AlexEkb4ever/MURMULATOR_RP3B_case_scheme/19RPI24/19RPI24.kicad_pcb

## KiCad design 19RPI24/19RPI24.kicad_pcb (2024-05-10)

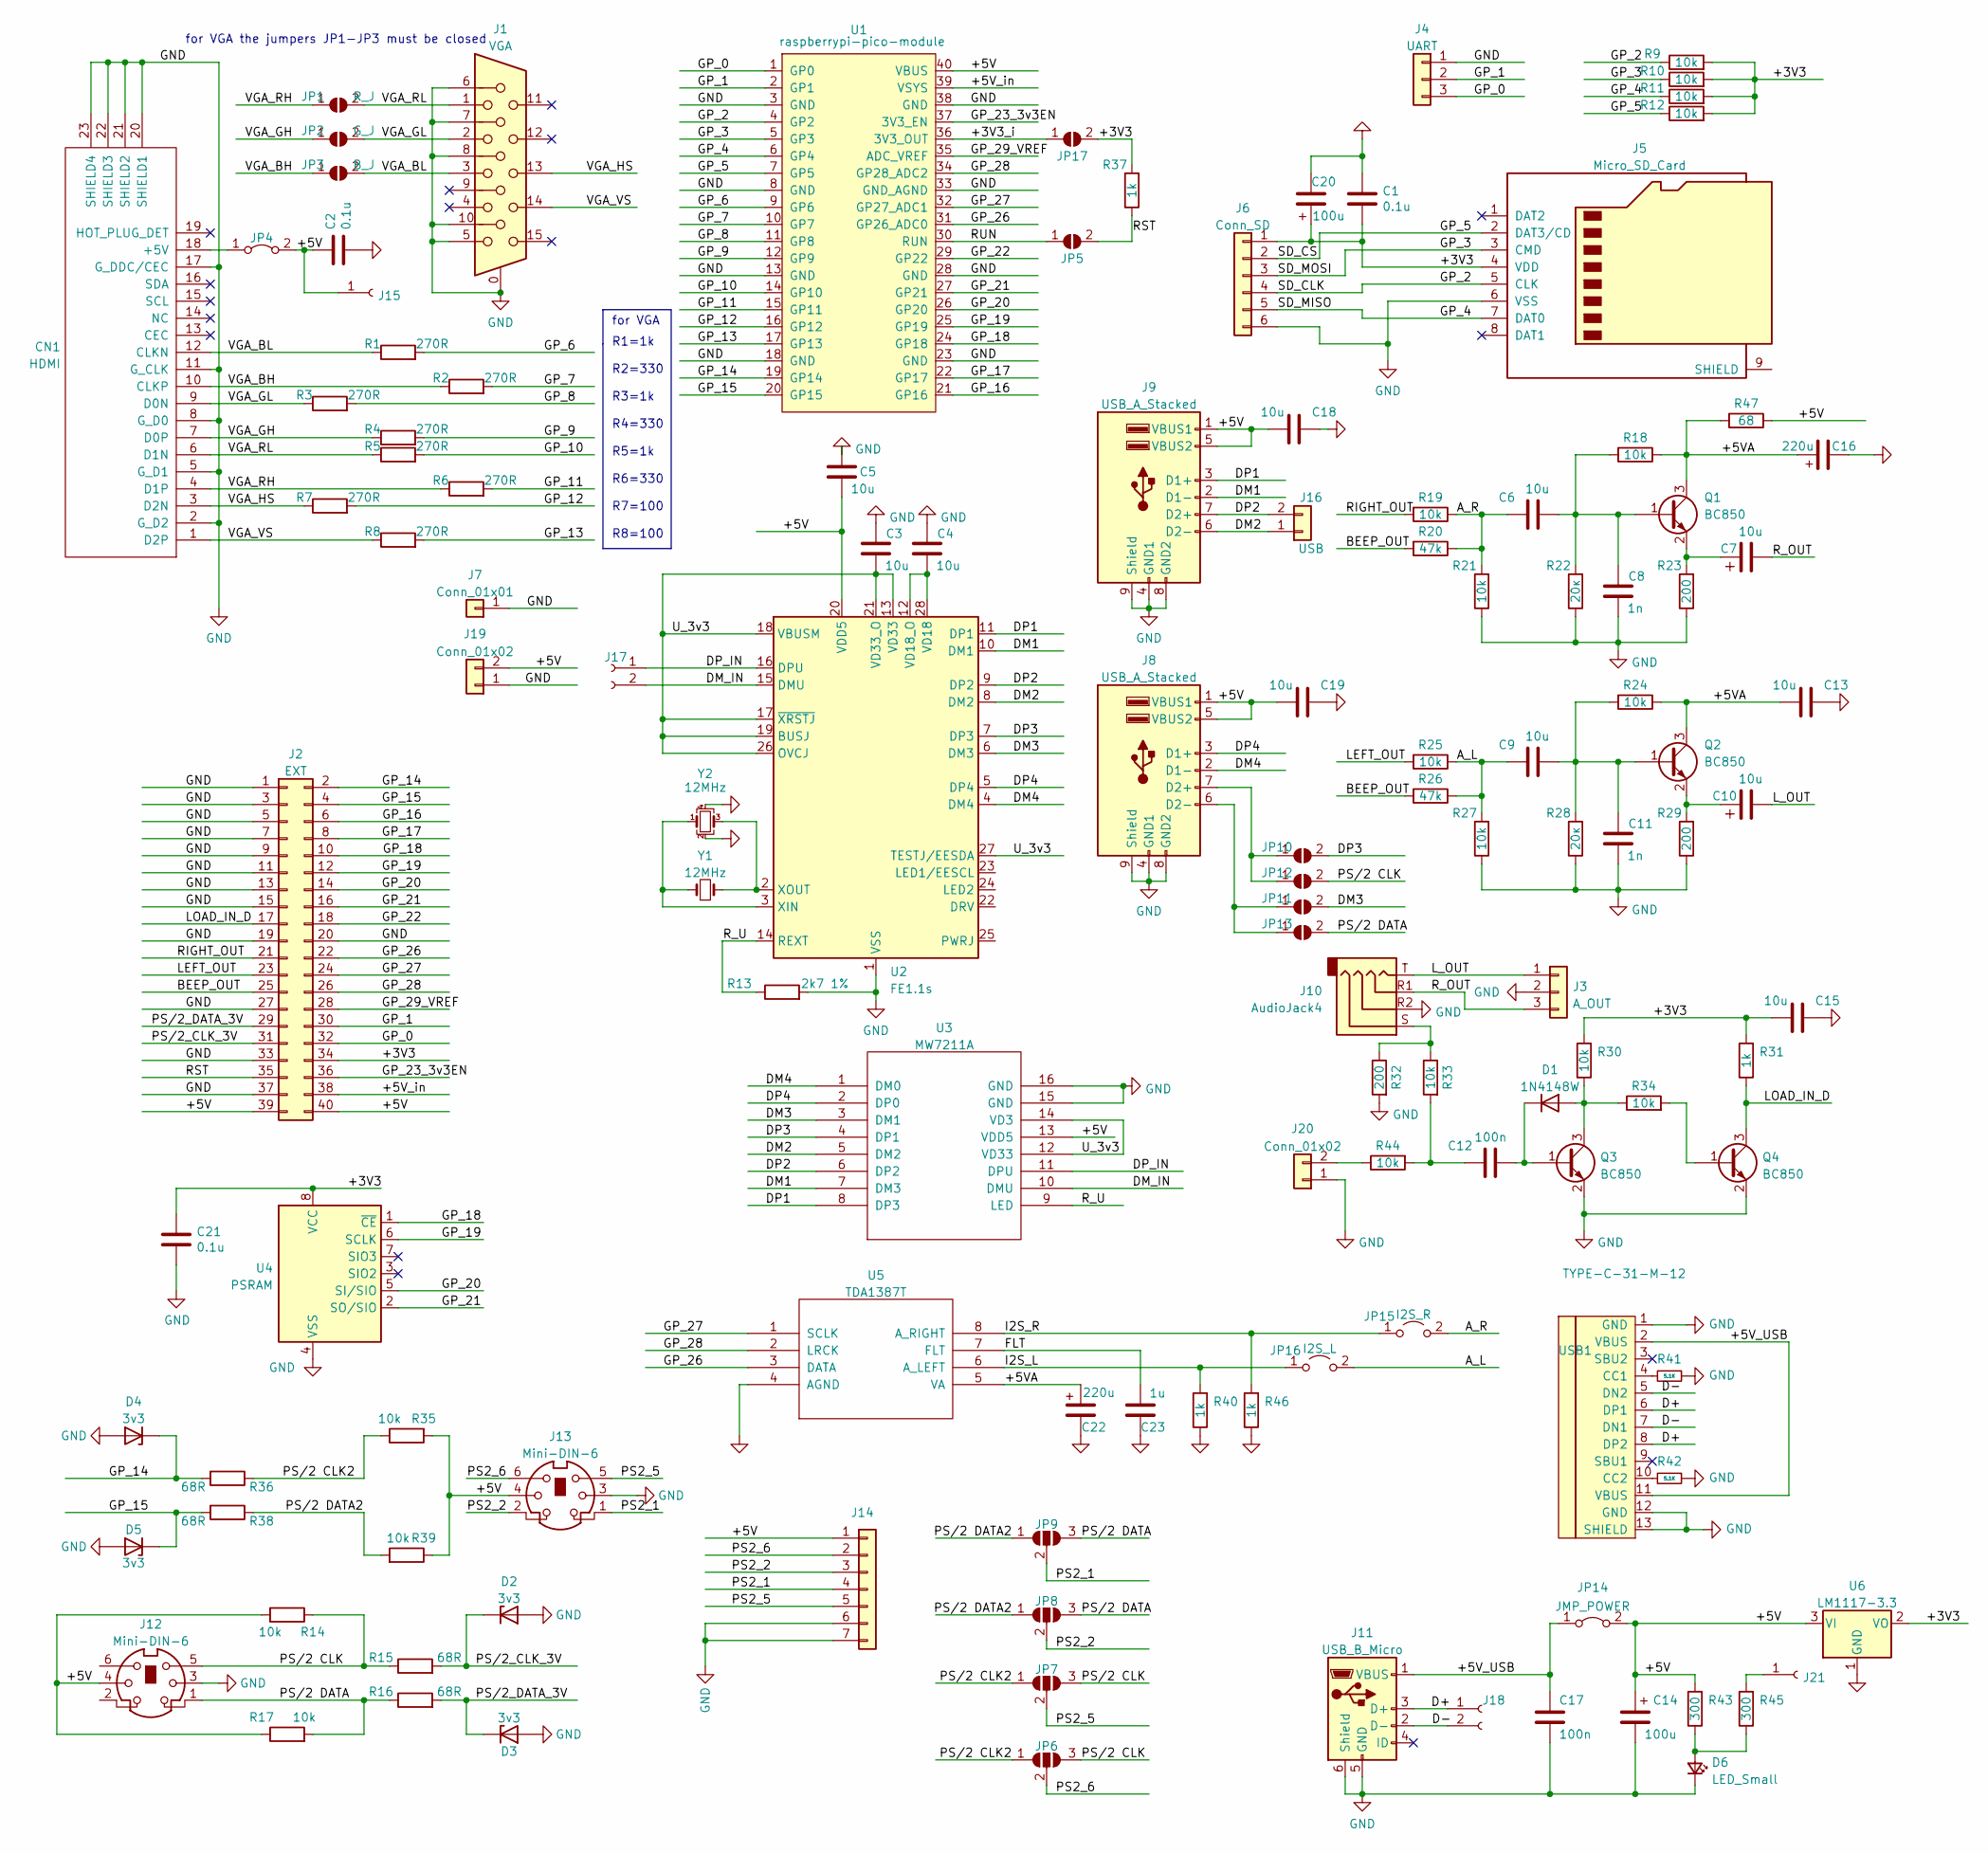
[picture p1: schematic 19RPI24.kicad_sch]

Parts:
C1, C21: 0.1u; C_0805_2012Metric_Pad1.18x1.45mm_HandSolder
C2: 0.1u; R_0805_PLUS
C3, C4, C5, C6, C9, C13, C15, C18, C19: 10u; C_0805_2012Metric_Pad1.18x1.45mm_HandSolder
C7, C10: 10u; c_comb_pol
C8, C11: 1n; C_0805_2012Metric_Pad1.18x1.45mm_HandSolder
C12, C17: 100n; C_0805_2012Metric_Pad1.18x1.45mm_HandSolder
C14, C20: 100u; c_comb_pol
C16: 220u; CP_EIA-3528-21_Kemet-B_Pad1.50x2.35mm_HandSolder
C22: 220u; CP_EIA-6032-28_Kemet-C
C23: 1u; C_0805_2012Metric_Pad1.18x1.45mm_HandSolder
CN1: HDMI
D1: 1N4148W; D_SOD-123
D2, D3, D4, D5: 3v3; D_0805_PLUS
D6: LED_Small; LED_1206_3216Metric_Pad1.42x1.75mm_HandSolder
J1: VGA; DSUB-15-HD_Female_Horizontal_P2.29x1.98mm_EdgePinOffset3.03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
J2: EXT; PinHeader_2x20_P2.54mm_Vertical
J3: A_OUT; PinHeader_1x03_P2.54mm_Vertical
J4: UART; PinHeader_1x03_P2.54mm_Vertical
J5: Micro_SD_Card; GCT-MEM2055-00-190-01-A
J6: Conn_SD; PinSocket_1x06_P2.54mm_Vertical
J7: Conn_01x01; PinHeader_1x01_P2.54mm_Vertical
J8, J9: USB_A_Stacked; USB_A_Wuerth_61400826021_Horizontal_Stacked
J10: AudioJack4; Jack_3.5mm_PJ320D_Horizontal
J11: USB_B_Micro; USB_Micro-B_Amphenol
J12, J13: Mini-DIN-6; Connector_Mini-DIN_Female_6Pin
J14: Conn_01x07; PinHeader_1x07_P2.54mm_Vertical
J15: Conn_01x01_Female; conn_1
J16: USB; PinHeader_1x02_P2.54mm_Vertical
J17, J18: Conn_01x02_Female; conn 2
J19, J20: Conn_01x02; PinHeader_1x02_P2.54mm_Vertical
J21: Conn_01x01_Female; Pin_D0.7mm_L6.5mm_W1.8mm_FlatFork
JP1, JP5, JP17: R_J; SolderJumper-2_P1.3mm_Open_RoundedPad1.0x1.5mm
JP2: G_J; SolderJumper-2_P1.3mm_Open_RoundedPad1.0x1.5mm
JP3: B_J; SolderJumper-2_P1.3mm_Open_RoundedPad1.0x1.5mm
JP4: Jumper_2_Bridged; SolderJumper-2_P1.3mm_Bridged_RoundedPad1.0x1.5mm
JP6, JP7, JP8, JP9: SolderJumper_3_Open; SolderJumper-3_P1.3mm_Open_RoundedPad1.0x1.5mm
JP10, JP11, JP12, JP13: J; SolderJumper-2_P1.3mm_Open_RoundedPad1.0x1.5mm
JP14: JMP_POWER; SolderJumper-2_P1.3mm_Bridged_RoundedPad1.0x1.5mm
JP15: I2S_R; PinHeader_1x02_P2.54mm_Vertical
JP16: I2S_L; PinHeader_1x02_P2.54mm_Vertical
Q1, Q2, Q3, Q4: BC850; SOT-23
R1, R2, R3, R4, R5, R6, R7, R8: 270R; R_0805_PLUS
R9, R10, R11, R12, R14, R17, R18, R19, R21, R24, R25, R27, R30, R33, R34, R35, R39, R44: 10k; R_0805_2012Metric_Pad1.20x1.40mm_HandSolder
R13: 2k7 1%; R_0805_2012Metric_Pad1.20x1.40mm_HandSolder
R15, R16, R36, R38: 68R; R_0805_2012Metric_Pad1.20x1.40mm_HandSolder
R20, R26: 47k; R_0805_2012Metric_Pad1.20x1.40mm_HandSolder
R22, R28: 20к; R_0805_2012Metric_Pad1.20x1.40mm_HandSolder
R23, R29, R32: 200; R_0805_2012Metric_Pad1.20x1.40mm_HandSolder
R31, R37, R40, R46: 1k; R_0805_2012Metric_Pad1.20x1.40mm_HandSolder
R41, R42: 5.1K; R_0805_2012Metric_Pad1.20x1.40mm_HandSolder
R43, R45: 300; R_0805_2012Metric_Pad1.20x1.40mm_HandSolder
R47: 68; R_0805_2012Metric_Pad1.20x1.40mm_HandSolder
U1: raspberrypi-pico-module; Raspberry_Pi_Pico_SMT_THT_MOD_3
U2: FE1.1s; SSOP-28_3.9x9.9mm_P0.635mm
U3: MW7211A; SO-16_5.3x10.2mm_P1.27mm
U4: PSRAM; SO-8_5.3x6.2mm_P1.27mm
U5: TDA1387T; SO-8_5.3x6.2mm_P1.27mm
U6: LM1117-3.3; SOT-223-3_TabPin2
USB1: TYPE-C-31-M-12; USB-TYPE-C-31-M-12_lib2; LCSC C165948
Y1: 12MHz; Crystal_HC49-4H_Vertical
Y2: 12MHz; Crystal_SMD_0603-4Pin_6.0x3.5mm

Connections:
/+3V3: C1.2, C15.2, C20.1, C21.1, J2.34, J5.4 (VDD), J6.1, JP17.2 (B), R9.2, R10.2, R11.2, R12.2, R30.2, R31.2, R37.2, U4.8 (VCC), U6.2 (VO); also elsewhere on the board
/+3V3_i: JP17.1 (A), U1.36 (3V3_OUT)
/+5V: C2.1, C5.2, C14.1, C18.2, C19.2, J2.39, J2.40, J8.1 (VBUS1), J8.5 (VBUS2), J9.1 (VBUS1), J9.5 (VBUS2), J12.4, J13.4, J14.1, J15.1, J19.2, JP4.2 (B), JP14.2 (B), R14.2, R17.1, R35.2, R39.1, R43.2, R47.1, U1.40 (VBUS), U2.20 (VDD5), U3.13 (VDD5), U6.3 (VI)
/+5VA: C13.2, C16.1, C22.1, Q1.3 (C), Q2.3 (C), R18.1, R24.1, R47.2, U5.5 (VA)
/+5V_USB: C17.1, J11.1 (VBUS), JP14.1 (A), USB1.2 (VBUS), USB1.11 (VBUS)
/+5V_in: J2.38, U1.39 (VSYS)
/A_L: C9.1, JP16.2 (B), R25.1, R26.1, R27.2
/A_R: C6.1, JP15.2 (B), R19.1, R20.1, R21.2
/BEEP_OUT: J2.25, R20.2, R26.2
/D+: J11.3 (D+), J18.1, USB1.6 (DP1), USB1.8 (DP2)
/D-: J11.2 (D-), J18.2, USB1.5 (DN2), USB1.7 (DN1)
/DM1: J9.2 (D1-), U2.10 (DM1), U3.7 (DM3)
/DM2: J9.6 (D2-), J16.1, U2.8 (DM2), U3.5 (DM2)
/DM3: JP11.2 (B), U2.6 (DM3), U3.3 (DM1)
/DM4: J8.2 (D1-), U2.4 (DM4), U3.1 (DM0)
/DM_IN: J17.2, U2.15 (DMU), U3.10 (DMU)
/DP1: J9.3 (D1+), U2.11 (DP1), U3.8 (DP3)
/DP2: J9.7 (D2+), J16.2, U2.9 (DP2), U3.6 (DP2)
/DP3: JP10.2 (B), U2.7 (DP3), U3.4 (DP1)
/DP4: J8.3 (D1+), U2.5 (DP4), U3.2 (DP0)
/DP_IN: J17.1, U2.16 (DPU), U3.11 (DPU)
/FLT: C23.2, U5.7 (FLT)
/GP_0: J2.32, J4.3, U1.1 (GP0)
/GP_1: J2.30, J4.2, U1.2 (GP1)
/GP_2: J5.5 (CLK), J6.4, R9.1, U1.4 (GP2)
/GP_3: J5.3 (CMD), J6.3, R10.1, U1.5 (GP3)
/GP_4: J5.7 (DAT0), J6.5, R11.1, U1.6 (GP4)
/GP_5: J5.2 (DAT3/CD), J6.2, R12.1, U1.7 (GP5)
/GP_6: R1.2, U1.9 (GP6)
/GP_7: R2.2, U1.10 (GP7)
/GP_8: R3.2, U1.11 (GP8)
/GP_9: R4.2, U1.12 (GP9)
/GP_10: R5.2, U1.14 (GP10)
/GP_11: R6.2, U1.15 (GP11)
/GP_12: R7.2, U1.16 (GP12)
/GP_13: R8.2, U1.17 (GP13)
/GP_14: D4.1 (K), J2.2, R36.2, U1.19 (GP14)
/GP_15: D5.1 (K), J2.4, R38.2, U1.20 (GP15)
/GP_16: J2.6, U1.21 (GP16)
/GP_17: J2.8, U1.22 (GP17)
/GP_18: J2.10, U1.24 (GP18), U4.1 (~CE)
/GP_19: J2.12, U1.25 (GP19), U4.6 (SCLK)
/GP_20: J2.14, U1.26 (GP20), U4.5 (SI/SIO)
/GP_21: J2.16, U1.27 (GP21), U4.2 (SO/SIO)
/GP_22: J2.18, U1.29 (GP22)
/GP_23_3v3EN: J2.36, U1.37 (3V3_EN)
/GP_26: J2.22, U1.31 (GP26_ADC0), U5.3 (DATA)
/GP_27: J2.24, U1.32 (GP27_ADC1), U5.1 (SCLK)
/GP_28: J2.26, U1.34 (GP28_ADC2), U5.2 (LRCK)
/GP_29_VREF: J2.28, U1.35 (ADC_VREF)
/I2S_L: JP16.1 (A), R40.2, U5.6 (A_LEFT)
/I2S_R: JP15.1 (A), R46.2, U5.8 (A_RIGHT)
/LEFT_OUT: J2.23, R25.2
/LOAD_IN_D: J2.17, Q4.3 (C), R31.1
/L_OUT: C10.2, J3.1, J10.T
/PS2_1: J13.1, J14.4, JP9.2 (C)
/PS2_2: J13.2, J14.3, JP8.2 (C)
/PS2_5: J13.5, J14.5, JP7.2 (C)
/PS2_6: J13.6, J14.2, JP6.2 (C)
/PS/2 CLK: J12.5, JP6.3 (B), JP7.3 (B), JP12.2 (B), R14.1, R15.1
/PS/2 CLK2: JP6.1 (A), JP7.1 (A), R35.1, R36.1
/PS/2 DATA: J12.1, JP8.3 (B), JP9.3 (B), JP13.2 (B), R16.1, R17.2
/PS/2 DATA2: JP8.1 (A), JP9.1 (A), R38.1, R39.2
/PS/2_CLK_3V: D2.1 (K), J2.31, R15.2
/PS/2_DATA_3V: D3.1 (K), J2.29, R16.2
/RIGHT_OUT: J2.21, R19.2
/RST: J2.35, JP5.2 (B), R37.1
/RUN: JP5.1 (A), U1.30 (RUN)
/R_OUT: C7.2, J3.3, J10.R1
/R_U: R13.1, U2.14 (REXT), U3.9 (LED)
/U_3v3: C3.2, U2.13 (VD33), U2.17 (~XRSTJ), U2.18 (VBUSM), U2.19 (BUSJ), U2.21 (VD33_O), U2.26 (OVCJ), U2.27 (TESTJ/EESDA), U3.12 (VD33), U3.14 (VD3)
/VGA_BH: CN1.10 (CLKP), JP3.1 (A), R2.1
/VGA_BL: CN1.12 (CLKN), J1.3, JP3.2 (B), R1.1
/VGA_GH: CN1.7 (D0P), JP2.1 (A), R4.1
/VGA_GL: CN1.9 (D0N), J1.2, JP2.2 (B), R3.1
/VGA_HS: CN1.3 (D2N), J1.13, R7.1
/VGA_RH: CN1.4 (D1P), JP1.1 (A), R6.1
/VGA_RL: CN1.6 (D1N), J1.1, JP1.2 (B), R5.1
/VGA_VS: CN1.1 (D2P), J1.14, R8.1
GND: C1.1, C2.2, C3.1, C4.1, C5.1, C8.2, C11.2, C13.1, C14.2, C15.1, C16.2, C17.2, C18.1, C19.1, C20.2, C21.2, C22.2, C23.1, CN1.2 (G_D2), CN1.5 (G_D1), CN1.8 (G_D0), CN1.11 (G_CLK), CN1.17 (G_DDC/CEC), CN1.20 (SHIELD1), CN1.21 (SHIELD2), CN1.22 (SHIELD3), CN1.23 (SHIELD4), D2.2 (A), D3.2 (A), D4.2 (A), D5.2 (A), D6.1 (K), J1.0, J1.5, J1.6, J1.7, J1.8, J1.10, J2.1, J2.3, J2.5, J2.7, J2.9, J2.11, J2.13, J2.15, J2.19, J2.20, J2.27, J2.33, J2.37, J3.2, J4.1, J5.6 (VSS), J6.6, J7.1, J8.4 (GND1), J8.8 (GND2), J8.9 (Shield), J9.4 (GND1), J9.8 (GND2), J9.9 (Shield), J10.R2, J11.5 (GND), J11.6 (Shield), J12.3, J13.3, J14.6, J14.7, J19.1, J20.1, Q3.2 (E), Q4.2 (E), R13.2, R21.1, R22.1, R23.1, R27.1, R28.1, R29.1, R32.2, R40.1, R41.1, R42.1, R46.1, U1.3 (GND), U1.8 (GND), U1.13 (GND), U1.18 (GND), U1.23 (GND), U1.28 (GND), U1.33 (GND_AGND), U1.38 (GND), U2.1 (VSS), U3.15 (GND), U3.16 (GND), U4.4 (VSS), U5.4 (AGND), U6.1 (GND), USB1.1 (GND), USB1.12 (GND), USB1.13 (SHIELD), Y2.2, Y2.4; also elsewhere on the board
unnamed: C4.2, U2.12 (VD18_O), U2.28 (VD18)
unnamed: C6.2, C8.1, Q1.1 (B), R18.2, R22.2
unnamed: C7.1, Q1.2 (E), R23.2
unnamed: C10.1, Q2.2 (E), R29.2
unnamed: C9.2, C11.1, Q2.1 (B), R24.2, R28.2
unnamed: C12.1, R33.2, R44.2
unnamed: C12.2, D1.1 (K), Q3.1 (B)
unnamed: CN1.18 (+5V), JP4.1 (A)
unnamed: D1.2 (A), Q3.3 (C), R30.1, R34.1
unnamed: D6.2 (A), R43.1, R45.1
unnamed: J8.6 (D2-), JP11.1 (A), JP13.1 (A)
unnamed: J8.7 (D2+), JP10.1 (A), JP12.1 (A)
unnamed: J10.S, R32.1, R33.1
unnamed: J20.2, R44.1
unnamed: J21.1, R45.2
unnamed: Q4.1 (B), R34.2
unnamed: R41.2, USB1.4 (CC1)
unnamed: R42.2, USB1.10 (CC2)
unnamed: U2.2 (XOUT), Y1.2, Y2.3
unnamed: U2.3 (XIN), Y1.1, Y2.1

Notes on the sheet:
for VGA
for VGA the jumpers JP1-JP3 must be closed
R1=1k R2=330 R3=1k R4=330 R5=1k R6=330 R7=100 R8=100

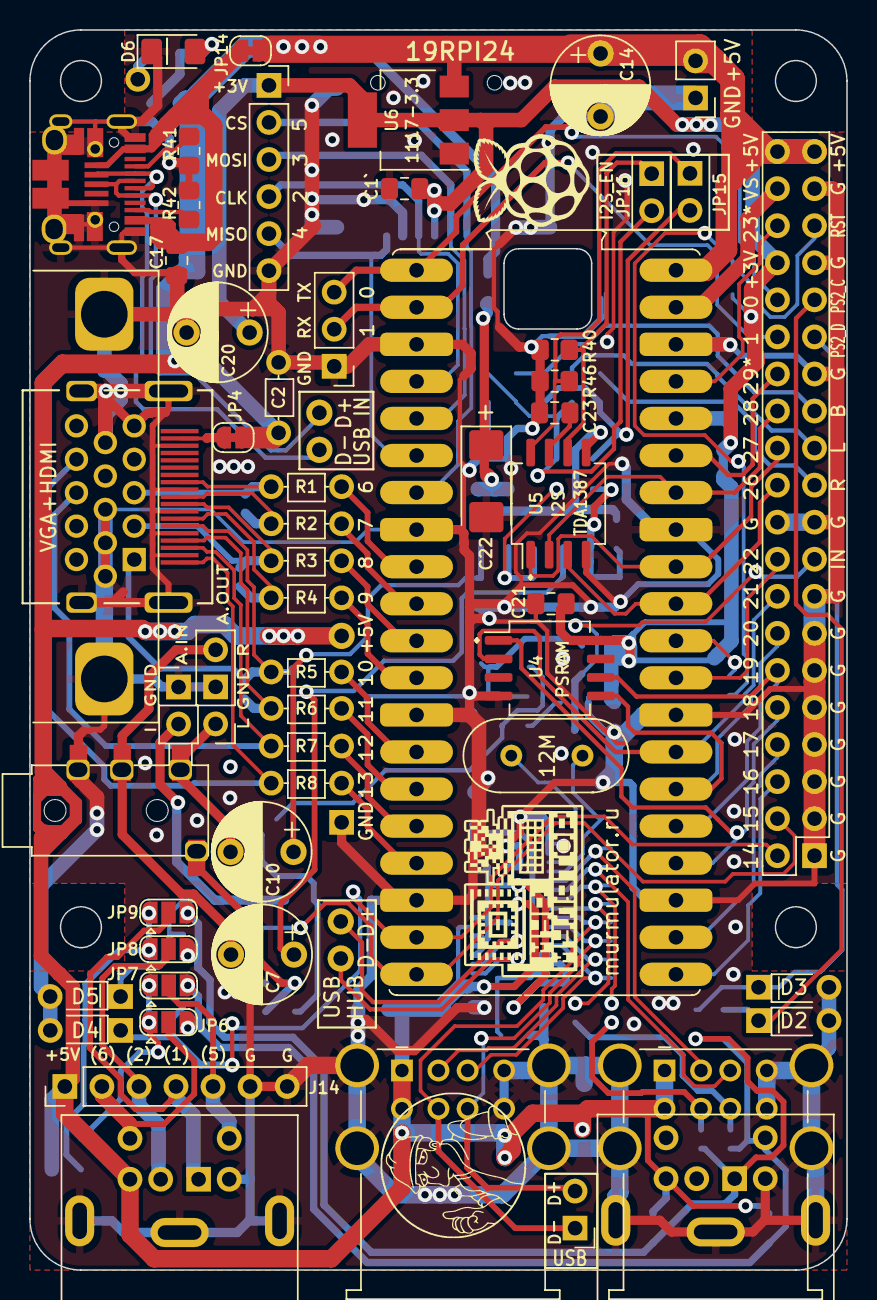
[picture p2: board 19RPI24.kicad_pcb from above]

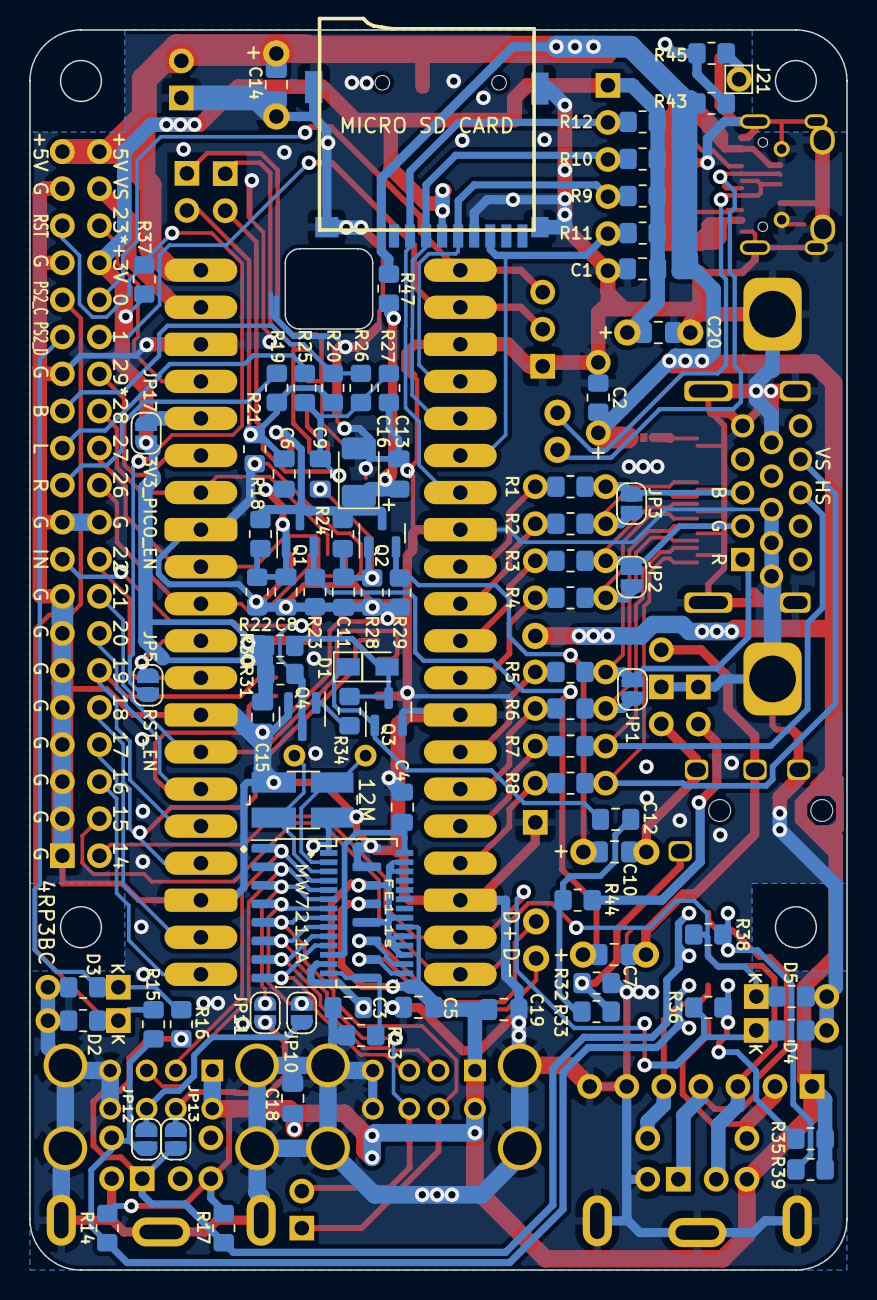
[picture p3: board 19RPI24.kicad_pcb from below]

Board: 2 copper layers, 56.0 x 85.0 mm, 129 parts (85 on the bottom side), 100 nets.

Other parts of the board:
C1`: 0.1u; C_0805_2012Metric_Pad1.18x1.45mm_HandSolder

Their connections:
/+3V3: C1`.2; also elsewhere on the board
GND: C1`.1; also elsewhere on the board
