AlexEkb4ever/MURMULATOR_RP3B_case_scheme/(commit log)

2023-08-15 .
    Power Led
    USB IN d+ d- position
    [33RPI23_rp3_case.kicad_pcb, 33RPI23_rp3_case.kicad_sch]
2023-08-18 +jumpers
    USB PS/2 jumpers
    [33RPI23_rp3_case.kicad_pcb, 33RPI23_rp3_case.kicad_sch]
2024-01-02 usb comb
    [33RPI23_rp3_case.kicad_pcb, 33RPI23_rp3_case.kicad_sch]
2024-05-04 16RP!24 create
    [16RPI24-B_Cu.gbl, 16RPI24-B_Mask.gbs, 16RPI24-B_Paste.gbp, 16RPI24-B_Silkscreen.gbo, 16RPI24-Edge_Cuts.gm1, 16RPI24-F_Cu.gtl, 16RPI24-F_Mask.gts, 16RPI24-F_Paste.gtp]
2024-05-08 add 1117
    [19RPI24-B_Cu.gbl, 19RPI24-B_Mask.gbs, 19RPI24-B_Paste.gbp, 19RPI24-B_Silkscreen.gbo, 19RPI24-Edge_Cuts.gm1, 19RPI24-F_Cu.gtl, 19RPI24-F_Mask.gts, 19RPI24-F_Paste.gtp]
